engineer6080/NATCAR/PCB.png

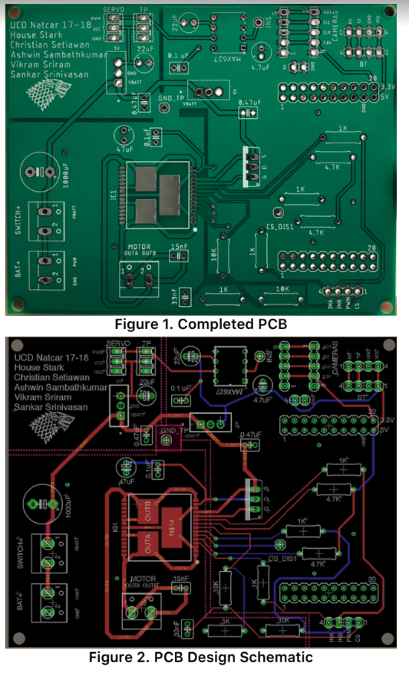
PCB.png
