engineer6080/NATCAR/README.md

# NATCAR
UC Davis Natcar project. Autonomous track navigation using PID control scheme.
