engineer6080/NATCAR/Overall.png

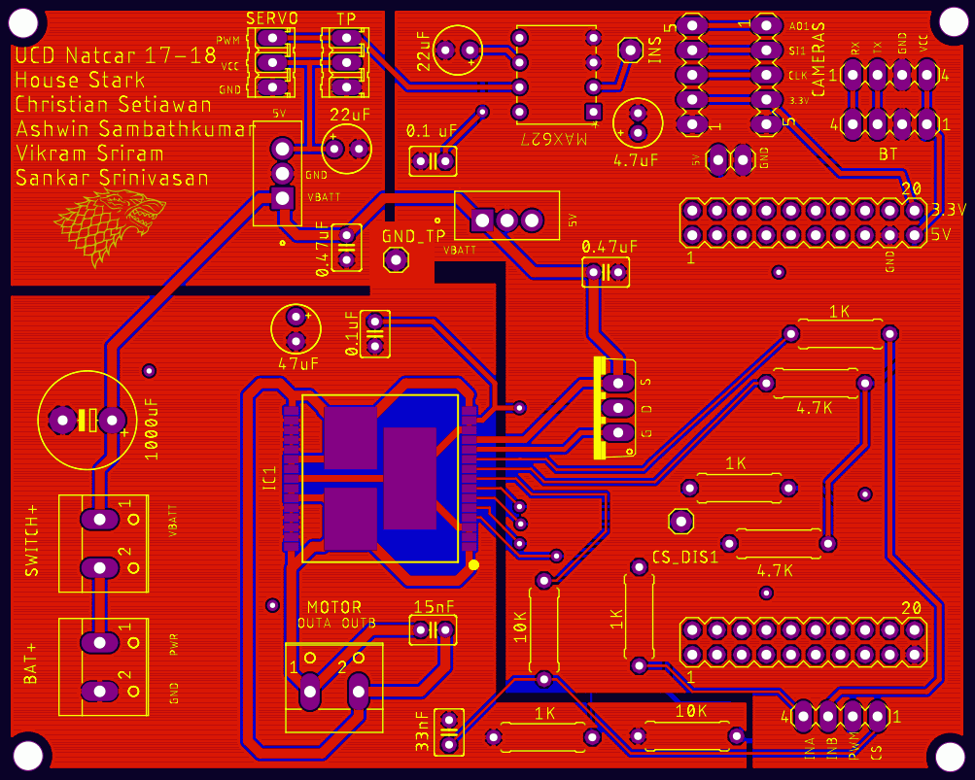
Overall.png
