engineer6080/NATCAR/Natcar.brd

## EAGLE design Natcar.brd (2019-12-31)

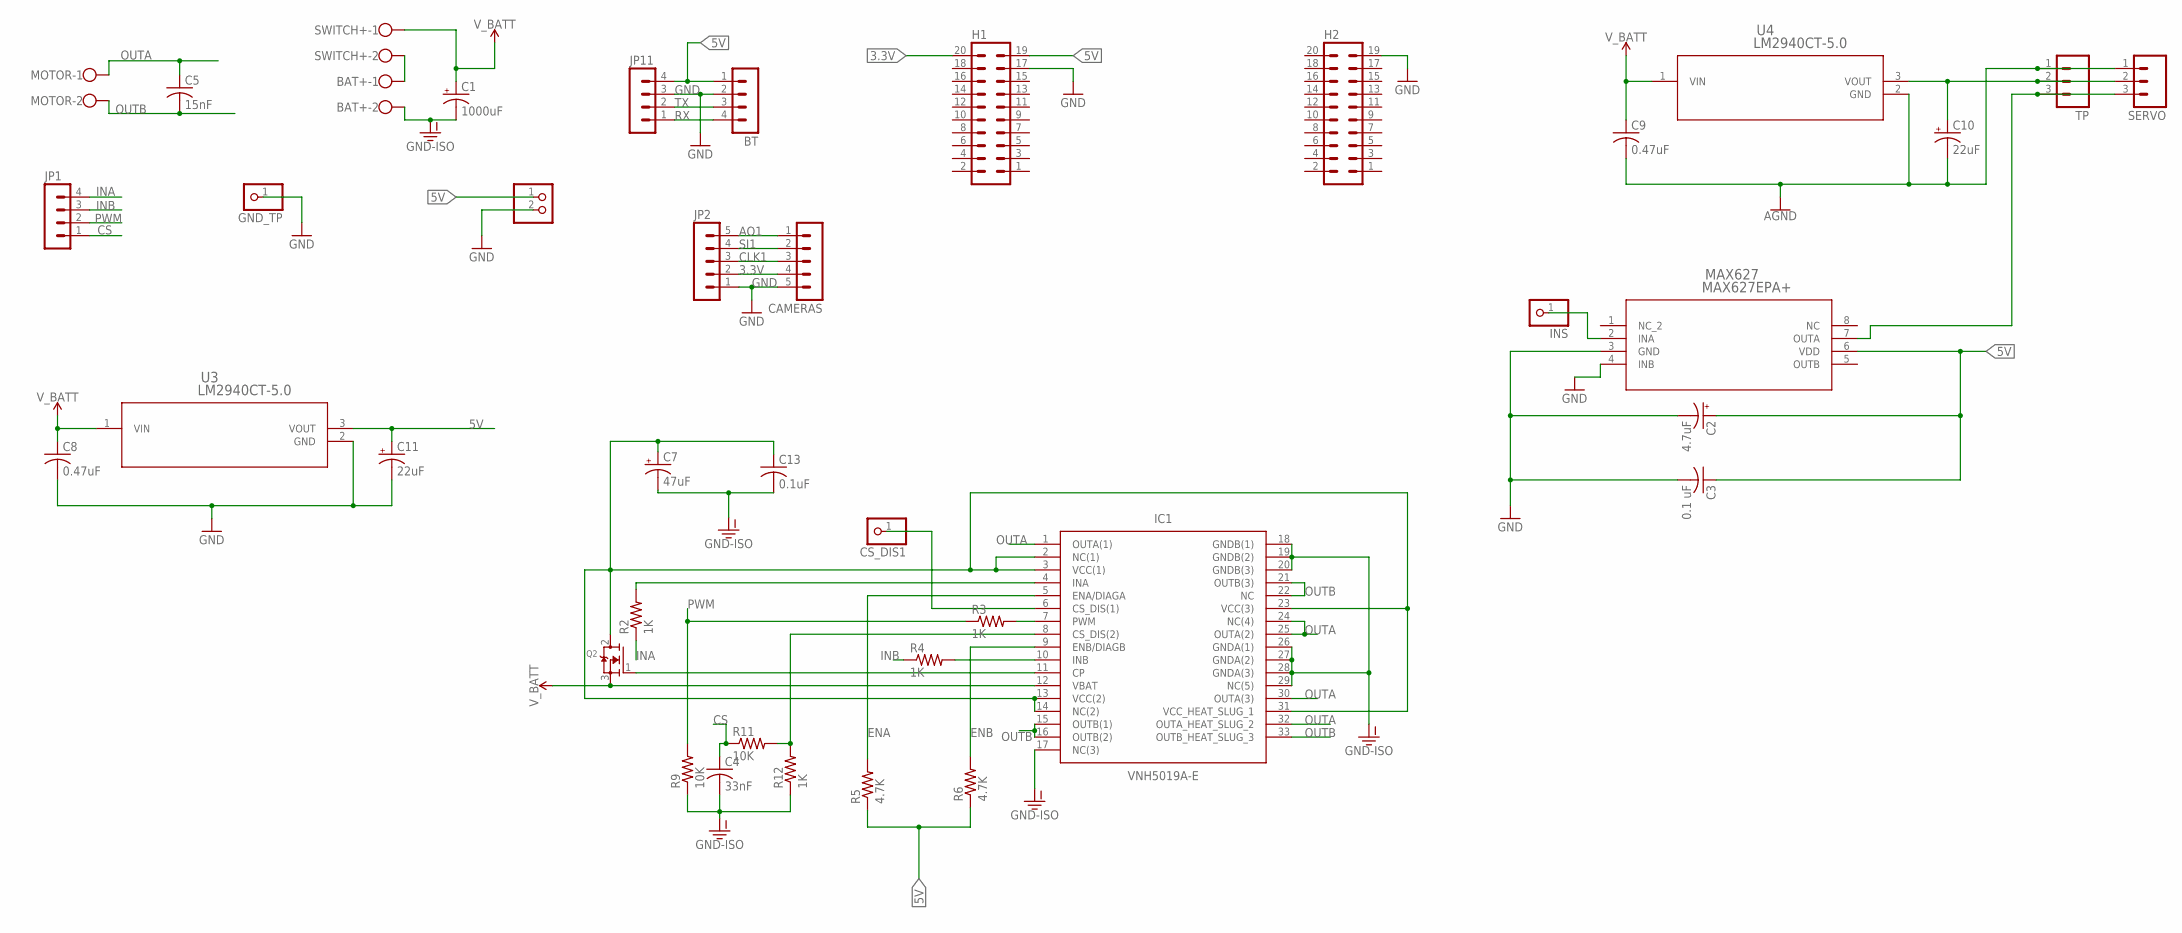
[picture p9: schematic Natcar.sch]

Parts:
BAT+: W237-102
BT: MA04-1
C1: 1000uF; E5-10,5
C2: 4.7uF; E2-5
C3: 0.1 uF; C025-030X050
C4: 33nF; C025-030X050
C5: 15nF; C025-030X050
C7: 47uF; E2,5-5
C8, C9: 0.47uF; C025-030X050
C10, C11: 22uF; E2,5-5
C13: 0.1uF; C025-030X050
CAMERAS: MA05-1
CS_DIS1: PINHD-1X1; 1X01
GND_TP: PINHD-1X1; 1X01
H1, H2: MA10-2
IC1: VNH5019A-E; VNH5019A-E_1
INS: PINHD-1X1; 1X01
JP1, JP11: MA04-1
JP2: MA05-1
JP12: PINHD-1X2; 1X02
MAX627: MAX627EPA+; 21-0043D_8
MOTOR: W237-102
Q2: MOSFET-NGDS_TO220V; TO220V
R2, R3, R4, R12: 1K; 0309/10
R5, R6: 4.7K; 0309/10
R9, R11: 10K; 0309/10
SERVO: MA03; 03P
SWITCH+: W237-102
TP: MA03; 03P
U3, U4: LM2940CT-5.0; T03B

Connections:
3.3V: CAMERAS.4, H1.20, JP2.2
5V: BT.1, C2.+, C3.1, C11.+, H1.19, JP11.4, JP12.1, MAX627.6 (VDD), R5.1, R6.1, U3.3 (VOUT)
AGND: C9.2, C10.-, SERVO.1, TP.1, U4.2 (GND)
AO1: CAMERAS.1, JP2.5
CLK1: CAMERAS.3, JP2.3
CS: C4.1, JP1.1, R11.1
ENA: IC1.5 (ENA/DIAGA), R5.2
ENB: IC1.9 (ENB/DIAGB), R6.2
GND: BT.2, C2.-, C3.2, C8.2, C11.-, CAMERAS.5, GND_TP.1, H1.17, H2.19, JP2.1, JP11.3, JP12.2, MAX627.3 (GND), MAX627.4 (INB), U3.2 (GND)
GND-ISO: BAT+.2, C1.-, C4.2, C7.-, C13.2, IC1.17 (NC(3)), IC1.18 (GNDB(1)), IC1.19 (GNDB(2)), IC1.20 (GNDB(3)), IC1.26 (GNDA(1)), IC1.27 (GNDA(2)), IC1.28 (GNDA(3)), IC1.29 (NC(5)), R9.1, R12.1
INA: JP1.4, R2.1
INB: JP1.3, R4.1
unnamed: BAT+.1, SWITCH+.2
unnamed: IC1.11 (CP), Q2.1 (G)
unnamed: IC1.10 (INB), R4.2
unnamed: C7.+, C13.1, IC1.2 (NC(1)), IC1.3 (VCC(1)), IC1.13 (VCC(2)), IC1.14 (NC(2)), IC1.23 (VCC(3)), IC1.31 (VCC_HEAT_SLUG_1), Q2.2 (D)
unnamed: IC1.4 (INA), R2.2
unnamed: CS_DIS1.1, IC1.6 (CS_DIS(1))
unnamed: IC1.7 (PWM), R3.2
unnamed: INS.1, MAX627.2 (INA)
unnamed: MAX627.7 (OUTA), SERVO.3, TP.3
unnamed: IC1.8 (CS_DIS(2)), R11.2, R12.2
unnamed: C10.+, SERVO.2, TP.2, U4.3 (VOUT)
OUTA: C5.1, IC1.1 (OUTA(1)), IC1.24 (NC(4)), IC1.25 (OUTA(2)), IC1.30 (OUTA(3)), IC1.32 (OUTA_HEAT_SLUG_2), MOTOR.1
OUTB: C5.2, IC1.15 (OUTB(1)), IC1.16 (OUTB(2)), IC1.21 (OUTB(3)), IC1.22 (NC), IC1.33 (OUTB_HEAT_SLUG_3), MOTOR.2
PWM: JP1.2, R3.1, R9.2
RX: BT.4, JP11.1
SI1: CAMERAS.2, JP2.4
TX: BT.3, JP11.2
V_BATT: C1.+, C8.1, C9.1, IC1.12 (VBAT), Q2.3 (S), SWITCH+.1, U3.1 (VIN), U4.1 (VIN)

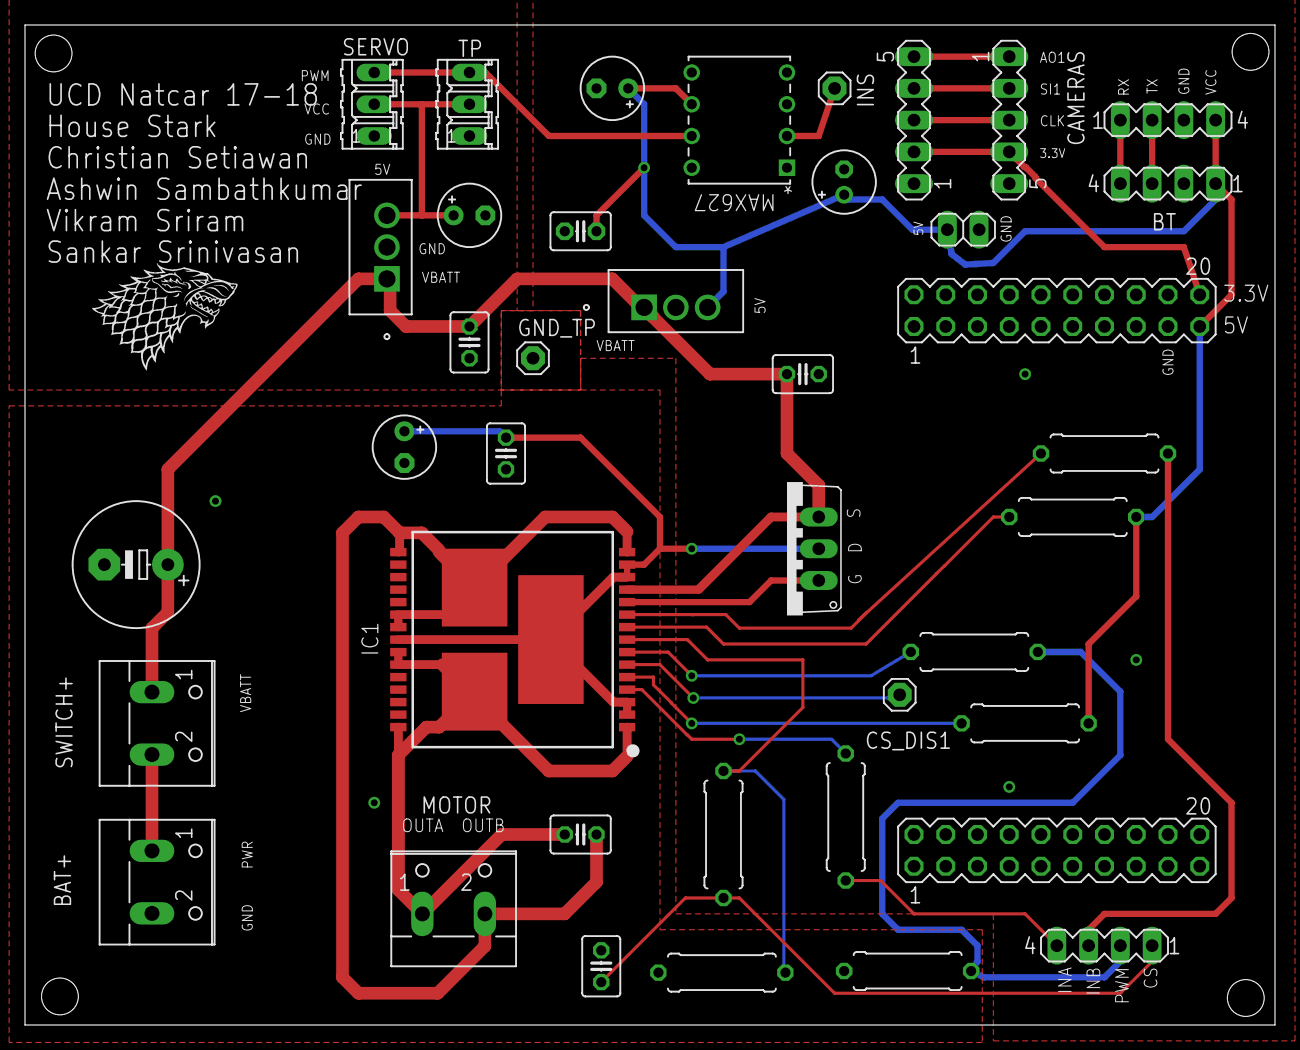
[picture p10: board Natcar.brd from above]

Board: 2 copper layers, 100.0 x 80.0 mm, 40 parts (0 on the bottom side), 30 nets.
